tronxi/real-time-tracking-system/doc/TFMTeXiS.tex

% ----------------------------------------------------------------------
%
%                            TFMTesis.tex
%
%----------------------------------------------------------------------
%
% Este fichero contiene el "documento maestro" del documento. Lo único
% que hace es configurar el entorno LaTeX e incluir los ficheros .tex
% que contienen cada sección.
%
%----------------------------------------------------------------------
%
% Los ficheros necesarios para este documento son:
%
%       TeXiS/* : ficheros de la plantilla TeXiS.
%       Cascaras/* : ficheros con las partes del documento que no
%          son capítulos ni apéndices (portada, agradecimientos, etc.)
%       Capitulos/*.tex : capítulos de la tesis
%       Apendices/*.tex: apéndices de la tesis
%       constantes.tex: constantes LaTeX
%       config.tex : configuración de la "compilación" del documento
%       guionado.tex : palabras con guiones
%
% Para la bibliografía, además, se necesitan:
%
%       *.bib : ficheros con la información de las referencias
%
% ---------------------------------------------------------------------

\documentclass[11pt,a4paper,twoside]{book}

%
% Definimos  el   comando  \compilaCapitulo,  que   luego  se  utiliza
% (opcionalmente) en config.tex. Quedaría  mejor si también se definiera
% en  ese fichero,  pero por  el modo  en el  que funciona  eso  no es
% posible. Puedes consultar la documentación de ese fichero para tener
% más  información. Definimos también  \compilaApendice, que  tiene el
% mismo  cometido, pero  que se  utiliza para  compilar  únicamente un
% apéndice.
%
%
% Si  queremos   compilar  solo   una  parte  del   documento  podemos
% especificar mediante  \includeonly{...} qué ficheros  son los únicos
% que queremos  que se incluyan.  Esto  es útil por  ejemplo para sólo
% compilar un capítulo.
%
% El problema es que todos aquellos  ficheros que NO estén en la lista
% NO   se  incluirán...  y   eso  también   afecta  a   ficheros  de
% la plantilla...
%
% Total,  que definimos  una constante  con los  ficheros  que siempre
% vamos a querer compilar  (aquellos relacionados con configuración) y
% luego definimos \compilaCapitulo.
\newcommand{\ficherosBasicosTeXiS}{%
TeXiS/TeXiS_pream,TeXiS/TeXiS_cab,TeXiS/TeXiS_bib,TeXiS/TeXiS_cover%
}
\newcommand{\ficherosBasicosTexto}{%
constantes,guionado,Cascaras/bibliografia,config%
}
\newcommand{\compilaCapitulo}[1]{%
\includeonly{\ficherosBasicosTeXiS,\ficherosBasicosTexto,Capitulos/#1}%
}

\newcommand{\compilaApendice}[1]{%
\includeonly{\ficherosBasicosTeXiS,\ficherosBasicosTexto,Apendices/#1}%
}

%- - - - - - - - - - - - - - - - - - - - - - - - - - - - - - - - - - -
%            Preámbulo del documento. Configuraciones varias
%- - - - - - - - - - - - - - - - - - - - - - - - - - - - - - - - - - -

% Define  el  tipo  de  compilación que  estamos  haciendo.   Contiene
% definiciones  de  constantes que  cambian  el  comportamiento de  la
% compilación. Debe incluirse antes del paquete TeXiS/TeXiS.sty
\include{config}

% Paquete de la plantilla
\usepackage{TeXiS/TeXiS}
\usepackage{graphicx}
\usepackage{eurosym}

% Incluimos el fichero con comandos de constantes
\include{constantes}

% Sacamos en el log de la compilación el copyright
%\typeout{Copyright Marco Antonio and Pedro Pablo Gomez Martin}

%
% "Metadatos" para el PDF
%
\ifpdf\hypersetup{%
    pdftitle = {\titulo},
    pdfsubject = {Plantilla de Tesis},
    pdfkeywords = {Plantilla, LaTeX, tesis, trabajo de
      investigación, trabajo de Master},
    pdfauthor = {\textcopyright\ \autor},
    pdfcreator = {\LaTeX\ con el paquete \flqq hyperref\frqq},
    pdfproducer = {pdfeTeX-0.\the\pdftexversion\pdftexrevision},
    }
    \pdfinfo{/CreationDate (\today)}
\fi

%- - - - - - - - - - - - - - - - - - - - - - - - - - - - - - - - - - -
%                        Documento
%- - - - - - - - - - - - - - - - - - - - - - - - - - - - - - - - - - -
\begin{document}

% Incluimos el  fichero de definición de guionado  de algunas palabras
% que LaTeX no ha dividido como debería
\input{guionado}

% Marcamos  el inicio  del  documento para  la  numeración de  páginas
% (usando números romanos para esta primera fase).
\frontmatter
\pagestyle{empty}

\include{Cascaras/cover}
%\include{Cascaras/autorizacion}
% \include{Cascaras/dedicatoria}
% \include{Cascaras/agradecimientos}
\include{Cascaras/resumen}
\begin{otherlanguage}{english}
\include{Cascaras/abstract}
% Si el trabajo se escribe en inglés, comentar esta línea y descomentar
% otra igual que hay justo antes de \end{document}
\end{otherlanguage}

\ifx\generatoc\undefined
\else
\include{TeXiS/TeXiS_toc}
\fi

% Marcamos el  comienzo de  los capítulos (para  la numeración  de las
% páginas) y ponemos la cabecera normal
\mainmatter

\pagestyle{fancy}
\restauraCabecera

\include{Capitulos/Introduccion}
\include{Capitulos/TrabajoRelaccionado}
\include{Capitulos/FundamentosTeoricos}
\include{Capitulos/DesarrolloTrabajo}
%\include{Capitulos/Capitulo4}
%\include{Capitulos/Capitulo5}
\include{Capitulos/ConclusionesTrabajoFuturo}

%%%%%%%%%%%%%%%%%%%%%%%%%%%%%%%%%%%%%%%%%%%%%%%%%%%%%%%%%%%%%%%%%%%%%%%%%%%
% Si el TFM se escribe en inglés, comentar las siguientes líneas 
% porque no es necesario incluir nuevamente las Conclusiones en inglés
\begin{otherlanguage}{english}
\include{Capitulos/Introduction}
\include{Capitulos/ConclusionsFutureWork}
\end{otherlanguage}
%%%%%%%%%%%%%%%%%%%%%%%%%%%%%%%%%%%%%%%%%%%%%%%%%%%%%%%%%%%%%%%%%%%%%%%%%%%

%
% Bibliografía
%
% Si el TFM se escribe en inglés, editar TeXiS/TeXiS_bib para cambiar el
% estilo de las referencias
\include{Cascaras/bibliografia}

% Apéndices
\appendix
\include{Apendices/appendixA}
\include{Apendices/appendixB}
%\include{Apendices/appendixC}
%\include{...}
%\include{...}
%\include{...}
\backmatter

%
% Índice de palabras
%

% Sólo  la   generamos  si  está   declarada  \generaindice.  Consulta
% TeXiS.sty para más información.

% En realidad, el soporte para la generación de índices de palabras
% en TeXiS no está documentada en el manual, porque no ha sido usada
% "en producción". Por tanto, el fichero que genera el índice
% *no* se incluye aquí (está comentado). Consulta la documentación
% en TeXiS_pream.tex para más información.
\ifx\generaindice\undefined
\else
%\include{TeXiS/TeXiS_indice}
\fi

%
% Lista de acrónimos
%

% Sólo  lo  generamos  si  está declarada  \generaacronimos.  Consulta
% TeXiS.sty para más información.

\ifx\generaacronimos\undefined
\else
\include{TeXiS/TeXiS_acron}
\fi

%
% Final
%
%\end{otherlanguage}
\end{document}
