tronxi/real-time-tracking-system/doc/constantes.tex

%---------------------------------------------------------------------
%
%                          constantes.tex
%
%---------------------------------------------------------------------
%
% Fichero que  declara nuevos comandos LaTeX  sencillos realizados por
% comodidad en la escritura de determinadas palabras
%
%---------------------------------------------------------------------

%%%%%%%%%%%%%%%%%%%%%%%%%%%%%%%%%%%%%%%%%%%%%%%%%%%%%%%%%%%%%%%%%%%%%%
% Comando: 
%
%       \titulo
%
% Resultado: 
%
% Escribe el título del documento.
%%%%%%%%%%%%%%%%%%%%%%%%%%%%%%%%%%%%%%%%%%%%%%%%%%%%%%%%%%%%%%%%%%%%%%
\def\titulo{Diseño e implementación de un sistema de adquisición, transmisión y visualización de datos basado en CanSat}

%%%%%%%%%%%%%%%%%%%%%%%%%%%%%%%%%%%%%%%%%%%%%%%%%%%%%%%%%%%%%%%%%%%%%%
% Comando: 
%
%       \autor
%
% Resultado: 
%
% Escribe el autor del documento.
%%%%%%%%%%%%%%%%%%%%%%%%%%%%%%%%%%%%%%%%%%%%%%%%%%%%%%%%%%%%%%%%%%%%%%
\def\autor{Sergio Garc\'ia S\'anchez}

% Variable local para emacs, para  que encuentre el fichero maestro de
% compilación y funcionen mejor algunas teclas rápidas de AucTeX

%%%
%%% Local Variables:
%%% mode: latex
%%% TeX-master: "tesis.tex"
%%% End:
