tronxi/real-time-tracking-system/doc/Cascaras/cover.tex

%---------------------------------------------------------------------
%
%                          configCover.tex
%
%---------------------------------------------------------------------
%
% cover.tex
% Copyright 2009 Marco Antonio Gomez-Martin, Pedro Pablo Gomez-Martin
%
% This file belongs to the TeXiS manual, a LaTeX template for writting
% Thesis and other documents. The complete last TeXiS package can
% be obtained from http://gaia.fdi.ucm.es/projects/texis/
%
% Although the TeXiS template itself is distributed under the 
% conditions of the LaTeX Project Public License
% (http://www.latex-project.org/lppl.txt), the manual content
% uses the CC-BY-SA license that stays that you are free:
%
%    - to share & to copy, distribute and transmit the work
%    - to remix and to adapt the work
%
% under the following conditions:
%
%    - Attribution: you must attribute the work in the manner
%      specified by the author or licensor (but not in any way that
%      suggests that they endorse you or your use of the work).
%    - Share Alike: if you alter, transform, or build upon this
%      work, you may distribute the resulting work only under the
%      same, similar or a compatible license.
%
% The complete license is available in
% http://creativecommons.org/licenses/by-sa/3.0/legalcode
%
%---------------------------------------------------------------------
%
% Fichero que contiene la configuración de la portada y de la 
% primera hoja del documento.
%
%---------------------------------------------------------------------

% Pueden configurarse todos los elementos del contenido de la portada
% utilizando comandos.

%%%%%%%%%%%%%%%%%%%%%%%%%%%%%%%%%%%%%%%%%%%%%%%%%%%%%%%%%%%%%%%%%%%%%%
% Título del documento:
% \tituloPortada{titulo}
% Nota:
% Si no se define se utiliza el del \titulo. Este comando permite
% cambiar el título de forma que se especifiquen dónde se quieren
% los retornos de carro cuando se utilizan fuentes grandes.
%%%%%%%%%%%%%%%%%%%%%%%%%%%%%%%%%%%%%%%%%%%%%%%%%%%%%%%%%%%%%%%%%%%%%%
\tituloPortada{%
Diseño e implementación de un sistema de adquisición, transmisión y visualización de datos basado en CanSat
}

%%%%%%%%%%%%%%%%%%%%%%%%%%%%%%%%%%%%%%%%%%%%%%%%%%%%%%%%%%%%%%%%%%%%%%
% Título del documento en inglés:
% \tituloPortadaEng{titulo}
% Nota:
% Si no se define se utiliza el del \titulo. Este comando permite
% cambiar el título de forma que se especifiquen dónde se quieren
% los retornos de carro cuando se utilizan fuentes grandes.
%%%%%%%%%%%%%%%%%%%%%%%%%%%%%%%%%%%%%%%%%%%%%%%%%%%%%%%%%%%%%%%%%%%%%%
\tituloPortadaEng{%
Design and Implementation of a CanSat-Based System for Data Acquisition, Transmission and Visualization
}

%%%%%%%%%%%%%%%%%%%%%%%%%%%%%%%%%%%%%%%%%%%%%%%%%%%%%%%%%%%%%%%%%%%%%%
% Autor del documento:
% \autorPortada{Nombre}
% Se utiliza en la portada y en el valor por defecto del
% primer subtítulo de la segunda portada.
%%%%%%%%%%%%%%%%%%%%%%%%%%%%%%%%%%%%%%%%%%%%%%%%%%%%%%%%%%%%%%%%%%%%%%
\autorPortada{Sergio Garc\'ia S\'anchez}

%%%%%%%%%%%%%%%%%%%%%%%%%%%%%%%%%%%%%%%%%%%%%%%%%%%%%%%%%%%%%%%%%%%%%%
% Fecha de publicación:
% \fechaPublicacion{Fecha}
% Puede ser vacío. Aparece en la última línea de ambas portadas
%%%%%%%%%%%%%%%%%%%%%%%%%%%%%%%%%%%%%%%%%%%%%%%%%%%%%%%%%%%%%%%%%%%%%%
% Descomentar para que ponga siempre la fecha actual
%\fechaPublicacion{\today}
% \fechaPublicacion{\textcolor{red}{DIA de MES de AÑO}}

%%%%%%%%%%%%%%%%%%%%%%%%%%%%%%%%%%%%%%%%%%%%%%%%%%%%%%%%%%%%%%%%%%%%%%
% Imagen de la portada (y escala)
% \imagenPortada{Fichero}
% \escalaImagenPortada{Numero}
% Si no se especifica, se utiliza la imagen TODO.pdf
%%%%%%%%%%%%%%%%%%%%%%%%%%%%%%%%%%%%%%%%%%%%%%%%%%%%%%%%%%%%%%%%%%%%%%
% imagen en blanco y negro
%\imagenPortada{Imagenes/Vectorial/escudoUCM}
%imagen en color
\imagenPortada{Imagenes/Bitmap/escudoUCMcolor}
\escalaImagenPortada{.2}

%%%%%%%%%%%%%%%%%%%%%%%%%%%%%%%%%%%%%%%%%%%%%%%%%%%%%%%%%%%%%%%%%%%%%%
% Tipo de documento.
% \tipoDocumento{Tipo}
% Para el texto justo debajo del escudo.
% Si no se indica, se utiliza "TESIS DOCTORAL".
%%%%%%%%%%%%%%%%%%%%%%%%%%%%%%%%%%%%%%%%%%%%%%%%%%%%%%%%%%%%%%%%%%%%%%
\tipoDocumento{Trabajo de Fin de Máster}

%%%%%%%%%%%%%%%%%%%%%%%%%%%%%%%%%%%%%%%%%%%%%%%%%%%%%%%%%%%%%%%%%%%%%%
% Institución/departamento asociado al documento.
% \institucion{Nombre}
% Puede tener varias líneas. Se utiliza en las dos portadas.
% Si no se indica aparecerá vacío.
%%%%%%%%%%%%%%%%%%%%%%%%%%%%%%%%%%%%%%%%%%%%%%%%%%%%%%%%%%%%%%%%%%%%%%
\institucion{%
Máster en Ingeniería Informática\\[0.2em]
Facultad de Informática\\[0.2em]
Universidad Complutense de Madrid
}

%%%%%%%%%%%%%%%%%%%%%%%%%%%%%%%%%%%%%%%%%%%%%%%%%%%%%%%%%%%%%%%%%%%%%%
% Director del trabajo.
% \directorPortada{Nombre}
% Se utiliza para el valor por defecto del segundo subtítulo, donde
% se indica quién es el director del trabajo.
% Si se fuerza un subtítulo distinto, no hace falta definirlo.
%%%%%%%%%%%%%%%%%%%%%%%%%%%%%%%%%%%%%%%%%%%%%%%%%%%%%%%%%%%%%%%%%%%%%%
\directorPortada{Adri\'an Riesco Rodr\'iguez}

%%%%%%%%%%%%%%%%%%%%%%%%%%%%%%%%%%%%%%%%%%%%%%%%%%%%%%%%%%%%%%%%%%%%%%
% Texto del primer subtítulo de la segunda portada.
% \textoPrimerSubtituloPortada{Texto}
% Para configurar el primer "texto libre" de la segunda portada.
% Si no se especifica se indica "Memoria que presenta para optar al
% título de Doctor en Informática" seguido del \autorPortada.
%%%%%%%%%%%%%%%%%%%%%%%%%%%%%%%%%%%%%%%%%%%%%%%%%%%%%%%%%%%%%%%%%%%%%%
\textoPrimerSubtituloPortada{%
\textbf{Trabajo de Fin de Máster en Ingeniería Informática}  \\ [0.3em]
\textbf{Departamento de Sistemas Informáticos y Computación} \\ [0.3em]
}

%%%%%%%%%%%%%%%%%%%%%%%%%%%%%%%%%%%%%%%%%%%%%%%%%%%%%%%%%%%%%%%%%%%%%%
% Texto del segundo subtítulo de la segunda portada.
% \textoSegundoSubtituloPortada{Texto}
% Para configurar el segundo "texto libre" de la segunda portada.
% Si no se especifica se indica "Dirigida por el Doctor" seguido
% del \directorPortada.
%%%%%%%%%%%%%%%%%%%%%%%%%%%%%%%%%%%%%%%%%%%%%%%%%%%%%%%%%%%%%%%%%%%%%%
\textoSegundoSubtituloPortada{%
% \textbf{Convocatoria: }\textit{\textcolor{red}{Febrero/Junio/Septiembre} \the\year} \\ [0.2em]
% \textbf{Calificación: }\textit{\textcolor{red}{Nota}}
}

%%%%%%%%%%%%%%%%%%%%%%%%%%%%%%%%%%%%%%%%%%%%%%%%%%%%%%%%%%%%%%%%%%%%%%
% \explicacionDobleCara
% Si se utiliza, se aclara que el documento está preparado para la
% impresión a doble cara.
%%%%%%%%%%%%%%%%%%%%%%%%%%%%%%%%%%%%%%%%%%%%%%%%%%%%%%%%%%%%%%%%%%%%%%
%\explicacionDobleCara

%%%%%%%%%%%%%%%%%%%%%%%%%%%%%%%%%%%%%%%%%%%%%%%%%%%%%%%%%%%%%%%%%%%%%%
% \isbn
% Si se utiliza, aparecerá el ISBN detrás de la segunda portada.
%%%%%%%%%%%%%%%%%%%%%%%%%%%%%%%%%%%%%%%%%%%%%%%%%%%%%%%%%%%%%%%%%%%%%%
%\isbn{978-84-692-7109-4}

%%%%%%%%%%%%%%%%%%%%%%%%%%%%%%%%%%%%%%%%%%%%%%%%%%%%%%%%%%%%%%%%%%%%%%
% \copyrightInfo
% Si se utiliza, aparecerá información de los derechos de copyright
% detrás de la segunda portada.
%%%%%%%%%%%%%%%%%%%%%%%%%%%%%%%%%%%%%%%%%%%%%%%%%%%%%%%%%%%%%%%%%%%%%%
%\copyrightInfo{\autor}

%%
%% Creamos las portadas
%%
\makeCover

% Variable local para emacs, para que encuentre el fichero
% maestro de compilación
%%%
%%% Local Variables:
%%% mode: latex
%%% TeX-master: "../Tesis.tex"
%%% End:
