tronxi/real-time-tracking-system/doc/Imagenes/Bitmap/18650.png

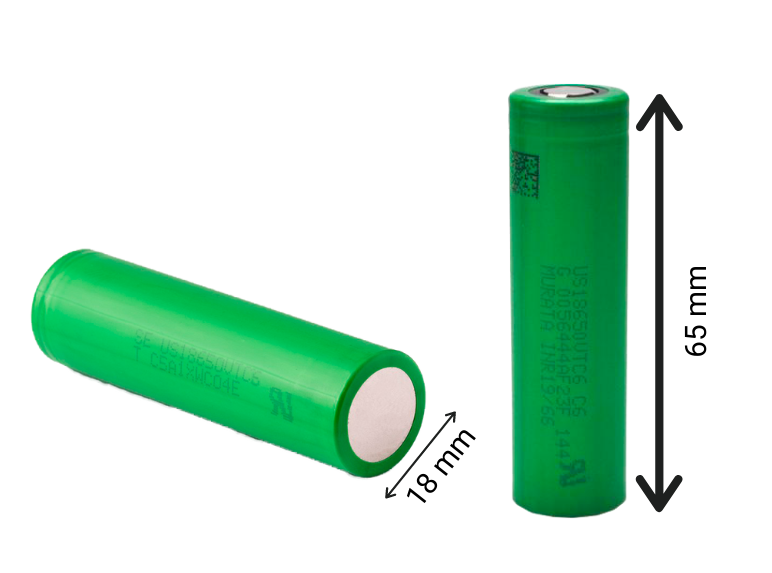
doc/Imagenes/Bitmap/18650.png
