tronxi/real-time-tracking-system/doc/Imagenes/Bitmap/antena_lora.png

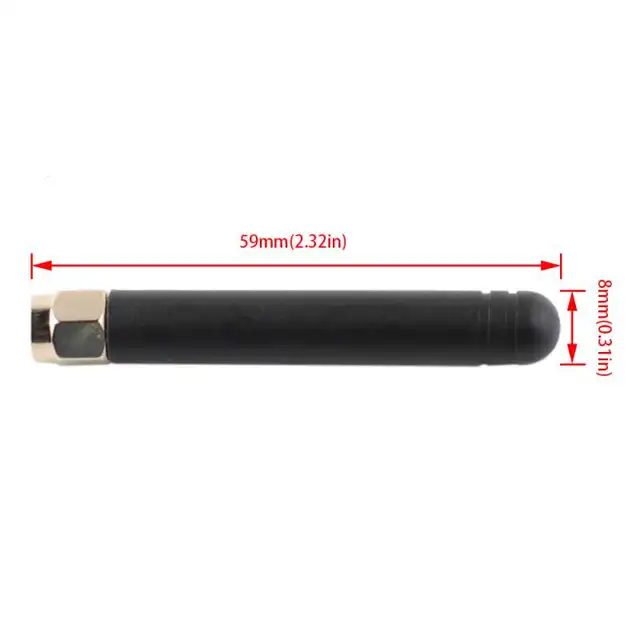
doc/Imagenes/Bitmap/antena_lora.png
