tronxi/real-time-tracking-system/doc/Imagenes/Bitmap/ras2.jpg

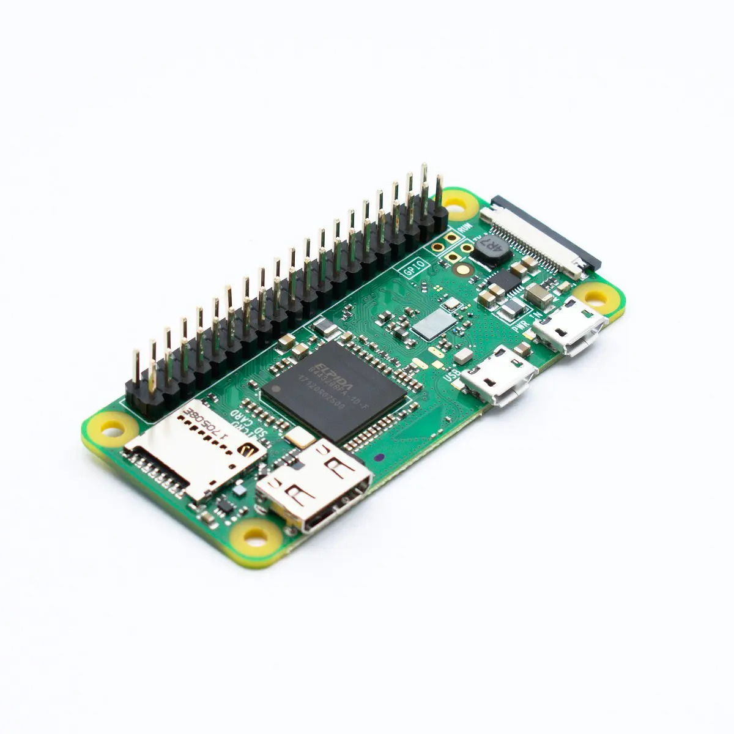
doc/Imagenes/Bitmap/ras2.jpg
