tronxi/real-time-tracking-system/doc/Imagenes/Bitmap/pcb_montaje_frontal_2.jpg

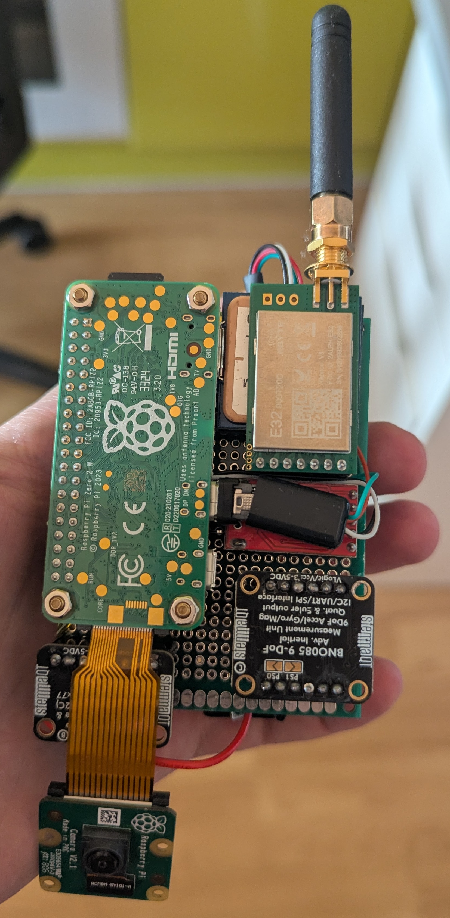
doc/Imagenes/Bitmap/pcb_montaje_frontal_2.jpg
