tronxi/real-time-tracking-system/doc/Imagenes/Bitmap/pcb_montaje_trasero_2.jpg

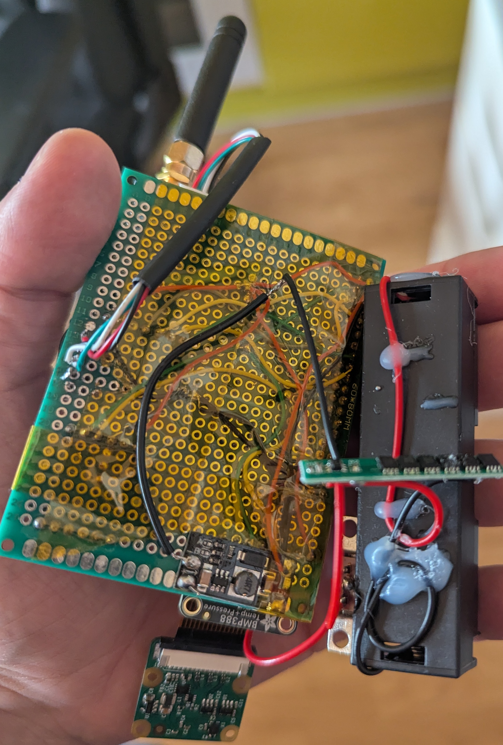
doc/Imagenes/Bitmap/pcb_montaje_trasero_2.jpg
