tronxi/real-time-tracking-system/(list of files, drawings)

Other design files:
design/design.fzz
design/design_esp32.fzz
