tronxi/real-time-tracking-system/tracking_device/esp32-controller/receiver/receiver.ino

#include <SPI.h>
#include <LoRa.h>

#define LORA_SCK   12
#define LORA_MISO  13
#define LORA_MOSI  11
#define LORA_CS    10
#define LORA_RST   9
#define LORA_DIO0  14

SPIClass SPI_LORA(FSPI);

void setup() {
  Serial.begin(115200);
  delay(2000);

  Serial.println("LoRa Receiver");

  SPI_LORA.begin(LORA_SCK, LORA_MISO, LORA_MOSI, LORA_CS);
  LoRa.setSPI(SPI_LORA);

  LoRa.setPins(LORA_CS, LORA_RST, LORA_DIO0);

  if (!LoRa.begin(433E6)) {
    Serial.println("Starting LoRa failed!");
    while (1);
  }

  LoRa.setSpreadingFactor(7);
  LoRa.setSignalBandwidth(250E3);
  LoRa.setCodingRate4(5);
  LoRa.setTxPower(14);
  LoRa.enableCrc();

  Serial.println("LoRa init OK, waiting for packets...");
}

void loop() {
  int packetSize = LoRa.parsePacket();
  if (packetSize) {
    while (LoRa.available()) {
      Serial.print((char)LoRa.read());
    }
    Serial.println();
  }
}
