tronxi/real-time-tracking-system/(commit log)

2023-05-25 added custom player and camera.py
2023-05-26 added tracking device code
2023-05-26 send images in other thread
2023-05-28 try exception from import camera
2023-05-29 remove old camera.py
2023-05-30 publish tracking device events
2023-05-31 use different connections for each thread
2023-06-01 remove print
2023-07-18 send cpu temperature
2023-07-18 show cpu temperature
2025-06-14 improve camera
2025-06-24 add esp32 controller
2025-06-27 add initial fritzing design
    [design.fzz]
2025-07-16 add camera offline
2025-07-16 fix camera offline
2025-07-16 fix encoder
2025-07-16 add yaw data
2025-07-16 add yaw
2025-07-17 remove yaw
2025-07-21 add bno085 i2c
2025-07-23 update design
    [design.fzz]
2025-07-28 add database for telemetry
    [design.fzz]
2025-07-30 radio and sensores
2025-09-21 esp32 lora
2025-09-22 add lora ground station
2025-10-03 add offline ground station
2026-01-31 update lora ground station
2026-02-01 update slides
    [design_esp32.fzz]
